enriquewph/INET-24-9-19-GRUPO-7/documentacion/esquematico.pdf

C1

U1

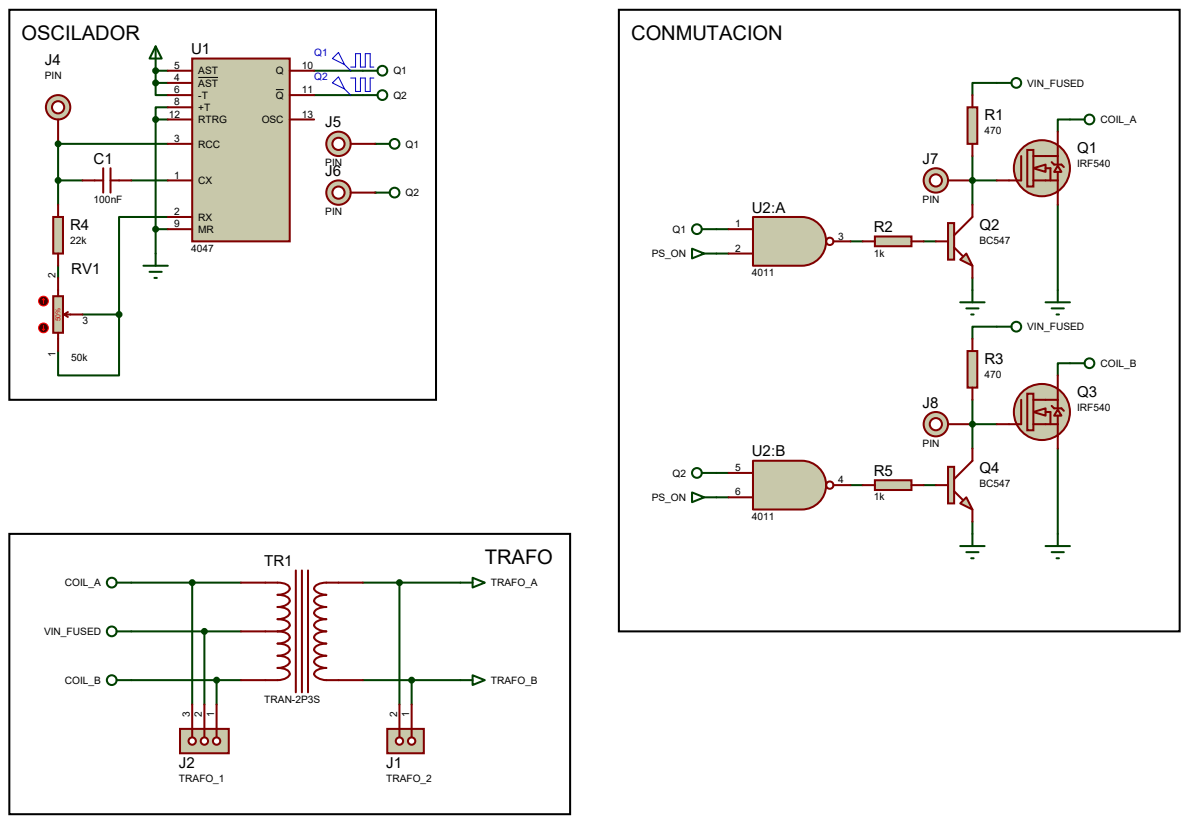
[picture p5: page 1]

C6

FU1

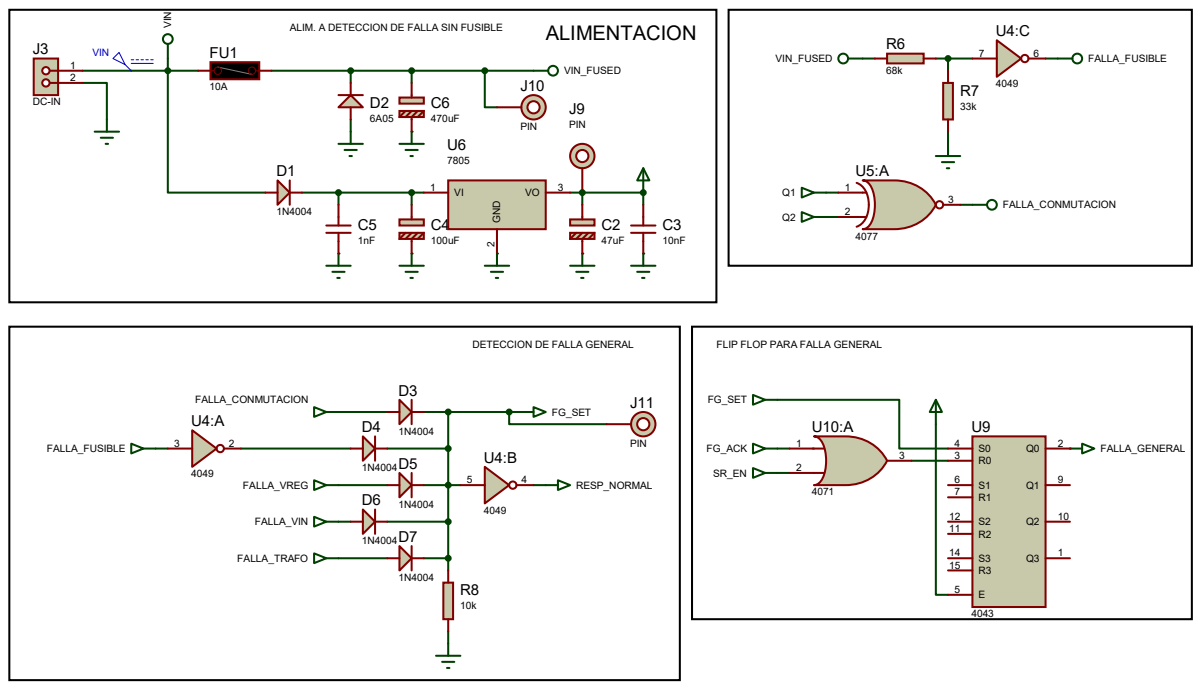
[picture p6: page 2]

DETECCION DE FALLA GENERAL

FLIP FLOP PARA FALLA GENERAL

R9
U11:A

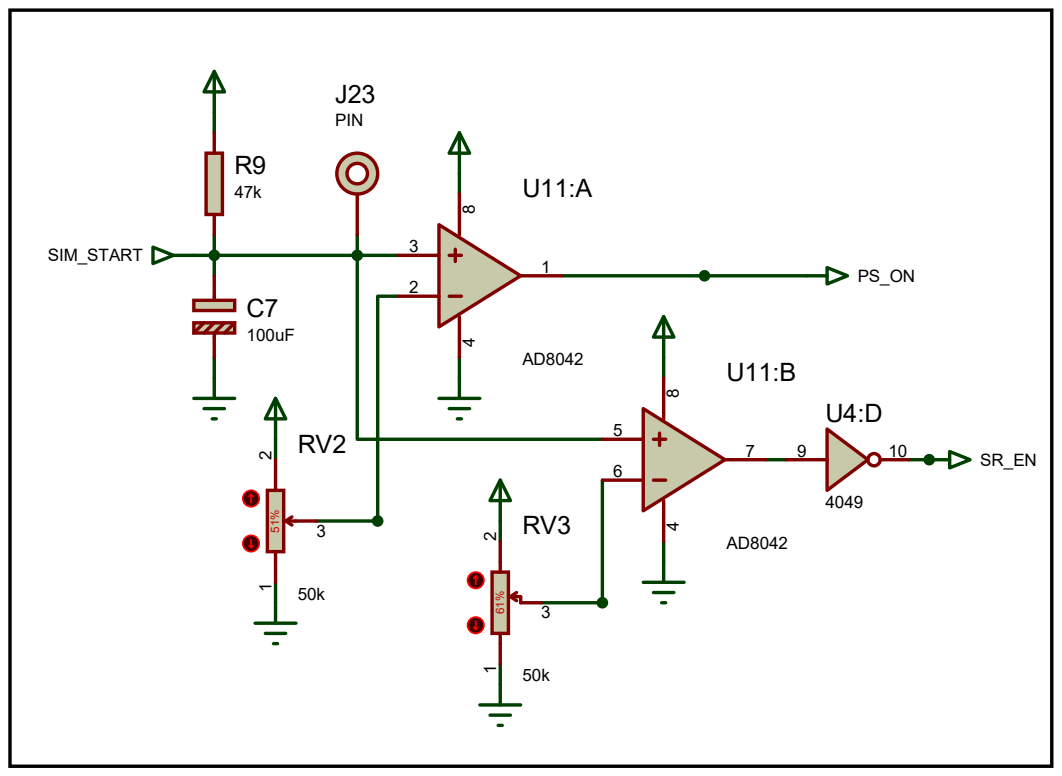
[picture p7: page 3]
SIM_START; PIN

## BUZ1

R22

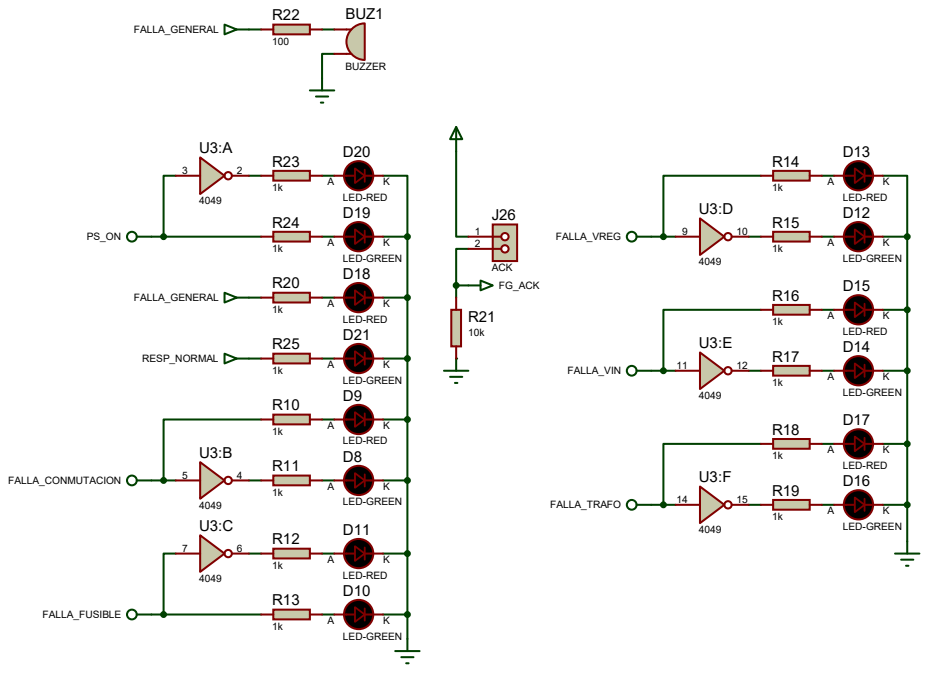
[picture p8: page 4]

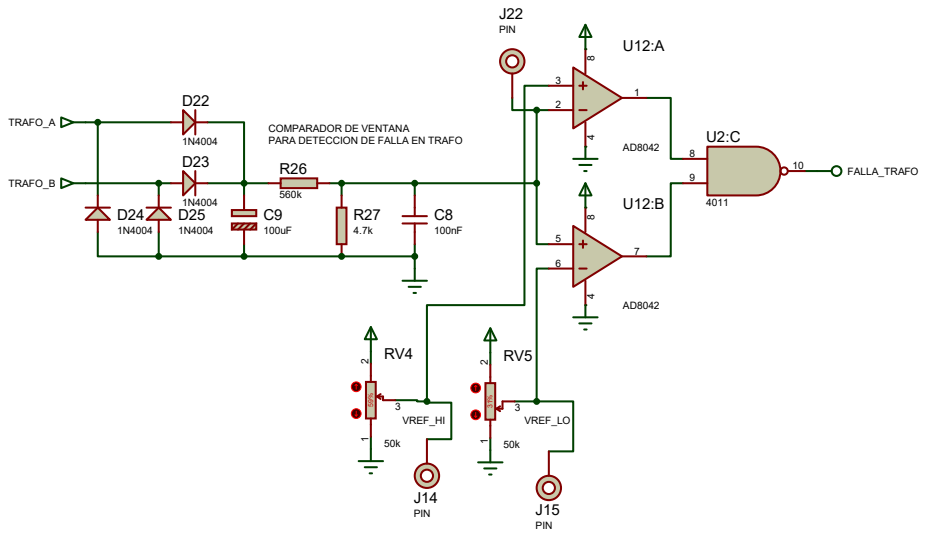
[picture p9: page 5]

COMPARADOR DE VENTANA
PARA DETECCION DE FALLA EN TRAFO

U13:A

U14:A

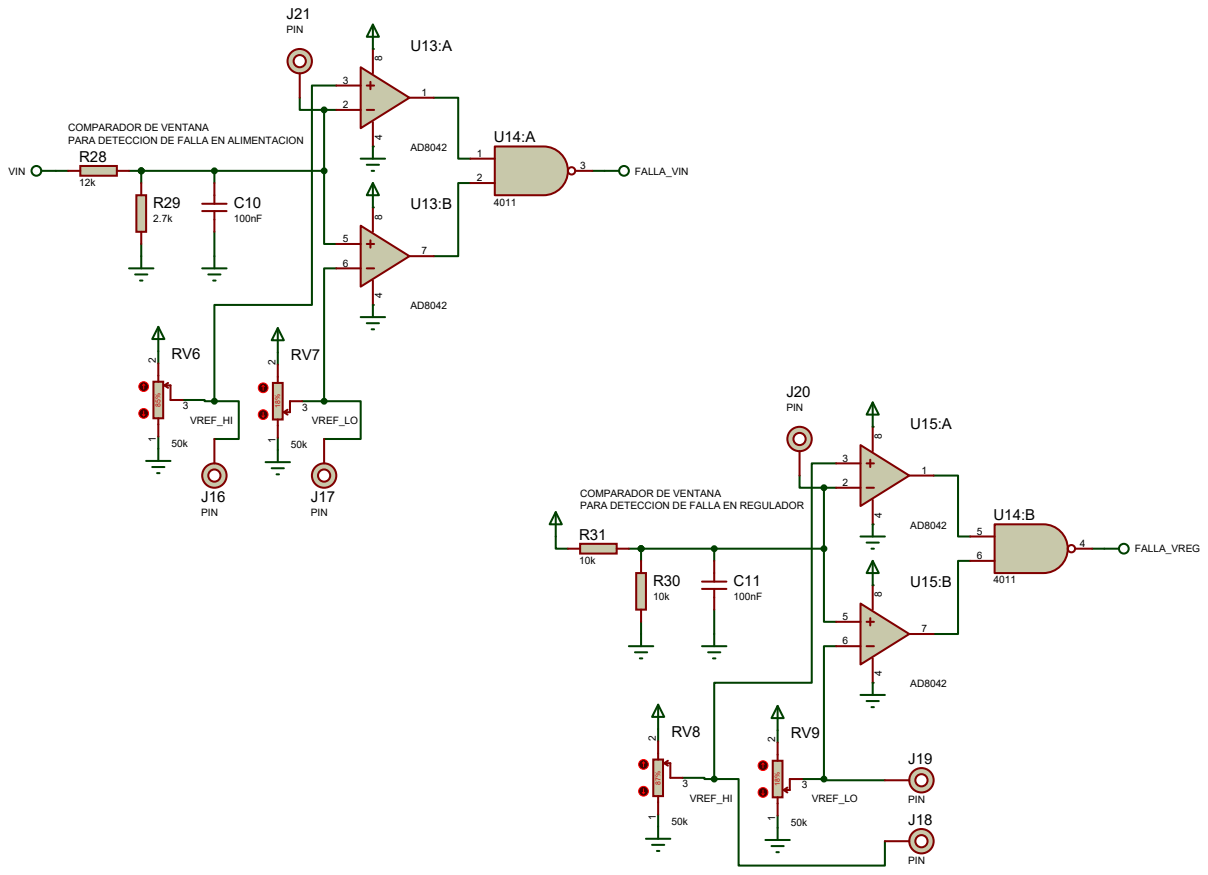
[picture p10: page 6]

COMPARADOR DE VENTANA
PARA DETECCION DE FALLA EN ALIMENTACION 85%

PARA DETECCION DE FALLA EN REGULADOR 87%
