enriquewph/INET-24-9-19-GRUPO-7/(list of files, drawings)

Other design files:
Simulacion2.pdsprj
Simulacion.pdsprj
Simulacion_MOSFET2.pdsprj
Simulacion_MOSFET.pdsprj
