enriquewph/INET-24-9-19-GRUPO-7/(commit log)

2019-09-24 initial commit v2
    [simulacion.pdsprj]
2019-09-26 PROYECTO INET INTERJURISDICCIONAL
    [Simulacion.pdsprj, Simulacion2.pdsprj, Simulacion_MOSFET.pdsprj, Simulacion_MOSFET2.pdsprj, simulacion.pdsprj]
